Pablo18011/DIY-RC-Lost-Alarm-MYRCLA6/Images/MYRCLA6V1.5FPCB1.png

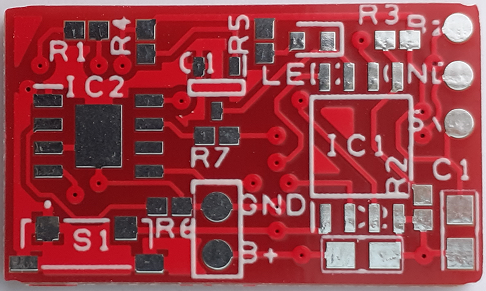
Images/MYRCLA6V1.5FPCB1.png
