Pablo18011/DIY-RC-Lost-Alarm-MYRCLA6/(threads)

Thread 1 (2021-12-26):

is it possible to use a Attiny13a instead of the Attint85?

bigjoncoop, 2021-12-26:
due to iventory shortage is it possible to use a Attiny13a instead of the Attint85?

when I try to compile/verify the code for the "DIY-RC-Lost-Alarm-MYRCLA6" with the Arduino IDE board set to MicroCore/Attiny13a i get the following error:

`
Arduino: 1.8.15 (Windows 10), Board: "ATtiny13, 9.6 MHz internal osc., EEPROM retained, BOD 2.7V, Micros disabled"
In file included from c:\users\administrator\appdata\local\arduino15\packages\arduino\tools\avr-gcc\7.3.0-atmel3.6.1-arduino7\avr\include\avr\io.h:99:0,
                 from C:\Users\Administrator\AppData\Local\Arduino15\packages\MicroCore\hardware\avr\2.2.0\cores\microcore/Arduino.h:17,
               from sketch\sketch_dec25a.ino.cpp:1:
C:\Users\Administrator\Documents\Arduino\sketch_dec25a\sketch_dec25a.ino: In function 'long int readVcc()':
sketch_dec25a:221:28: error: 'MUX3' was not declared in this scope
 ADMUX = _BV(REFS0) | _BV(MUX3) | _BV(MUX2) | _BV(MUX1);
                           ^
C:\Users\Administrator\Documents\Arduino\sketch_dec25a\sketch_dec25a.ino:221:28: note: suggested alternative: 'MUX0'
sketch_dec25a:221:40: error: 'MUX2' was not declared in this scope
  ADMUX = _BV(REFS0) | _BV(MUX3) | _BV(MUX2) | _BV(MUX1);
                                        ^
C:\Users\Administrator\Documents\Arduino\sketch_dec25a\sketch_dec25a.ino:221:40: note: suggested alternative: 'MUX0'

exit status 1

'MUX3' was not declared in this scope
`

Pablo18011, 2023-02-20:
Apologies, I have been busy working on other projects, sorry I have not responded.
I’m not familiar with the spec of the Attiny 13a?
You have to compare the specifications, you can still source the Attiny85’s, unfortunately like everything else, electronic components have gone up in price and can be difficult to source.

Thread 2 (2023-09-26):

Some comments on this project

dkroiss38, 2023-09-26:
Pablo,
First I want to thank you for the work you have done and shared with the community.  I definitively triggered curiosoty and I started to build your project.
I am fairly new to Github and did not find a better way to contact you for posting my comments.
First regarding battery measurement.  I found that not only the slope of the curve would need an adjustment but also the offset.  Analyzing your data shows that you have also a potential offset to be compensated.  I thus have two constants where Vbat=K1/result+K2.  For some reason I did not yet figure out, these canstants vary somewhat depending on how you calibrate.  Finaly, since I wanted to build several of these devices, I preferred writing these constants into the EEPROM, this way I hava a single code source fitting all the devices.  At code start I read these constants from the EEPROM.  Writing the EEPROM can be done with a tool like avrdudess.  You also need to change the fuse settings to avoid erasing the EEPROM at each code download.
Second I think that the variable stInValue is useless, there is even a ; after the if using this variable.
Third, I am using this for model airplane and I found that the sleep current is about 60µA rather than <1µA.  This is due to the fact that there is some loading in the receiver PWM output.  I thus changed the INPUT_PULLUP setting of input 1 (buzzIn) to INPUT.   Now I have a nce low sleep current.
And last, I measured the active current of the Attiny85 to be 5.5mA.  This current is taken from the battery continuously.  As long as the LMA is connected to the battery there is no concern, but in case the alarm is ejected than this current becomes significant in terms of alarm duration.  I did finally set the clock frequency of the Attiny to 1MHz and saved continuous 4mA.  To do this just set the frequency to 1MHz before making the bootloading or change the fuses accordingly (but don't forget the save EEPROM bit).

Thanks again for having shared this project and hope that my comment might help you or anyone else.
