Pablo18011/DIY-RC-Lost-Alarm-MYRCLA6/(commit log)

2020-07-10 Create Schematic
2020-07-10 Create Gerber Files MRCLA6
2021-01-23 MYRCLA6 V1.5 Update
    Images of V1.5 PCB with 3 pin connector
    and 2nd rest tactile push switch.
2021-01-23 Update README.md
    Update V 1.5 PCB
2021-01-23 Update MYRCLA6 Component List.txt
    V 1.5 PCB Components update.
2021-01-23 Create MYRCLA6 V1.5.zip
    V 1.5 PCB Gerber files.
